krmlbrc/meetingrecorder/(commit log)

2026-10-20 SD recorder: use 4 MHz SPI for reliability over jumper wires
    Claude-Session: https://claude.ai/code/session_01F15MbLKTCttt3moJTpb4cR
2026-10-20 Document IN-OUT jumper fix for SD module power on YD-ESP32-S3
    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
2026-10-20 SD recorder: use 1 MHz SPI, the speed verified on real hardware
    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
